ppalazon/hspecid-x/docs/includes/abbreviations.md

*[HSP]: HyperSpectral Pixel
*[HSI]: HyperSpectral Image
*[X-HEEP]: eXtendable Heterogeneous Energy-Efficient Platform
*[OBI]: Open Bus Interface
*[UAV]: Unmanned Aereal Vehicle
*[ECOSTRESS]: ECOsystem Spaceborne Thermal Radiometer Experiment on Space Station
*[VIS]: Visible
*[SWIR]: Shortwave Infrared
*[TIR]: Thermal Infrared
*[CNN]: Convolutional Neural Networks
*[GPU]: Graphics Processing Unit
*[FPGA]: Field-programmable gate array
*[ASIC]: Application-specific integrated circuit
*[DSA]: Domain-Specific Architecture
*[RTL]: Register Transfer Level
*[SoC]: System-on-a-Chip
*[MSE]: Mean Squared Error
*[MAD]: Mean Average Deviation
*[SAM]: Spectral Angle Mapper
*[SVA]: SystemVerilog Assertions
*[ISA]: Instruction Set Architecture
*[RISC]: Reduced Instruction Set Computer
*[ARM]: Advanced RISC Machines
*[CORE-V-XIF]: eXtension InterFace
*[XAIF]: eXtendible Accelerator InterFace
*[CGRA]: Coarse-Grained Reconfigurable Array
*[IMC]: In-Memory Computing
*[HLS]: High-Level Synthesis
*[FIFO]: First In, First Out
*[HSID]: HyperSpectral Identificator
*[CPU]: Central Processing Unit
*[DMA]: Direct Memory Access
*[IP]: Intellectual Property
*[AXI]: Advanced eXtensible Interface
*[AHB]: Advanced High-performance Bus
*[APB]: Advanced Peripheral Bus
*[DSP]: Digital Signal Processing
*[FSM]: Finite State Machine
*[DUT]: Device Under Test
*[RTOS]: Real-Time Operating System
*[UVM]: Universal Verification Methodology
