ppalazon/hspecid-x/reports/index.html

# Verificación de HSpecID-X

- hsid_fifo
- hsid_sq_df_acc
- hsid_mse
- hsid_mse_comp
- hsid_main
- hsid_x_obi_mem
- hsid_x_registers
- hsid_x_top
