ppalazon/hspecid-x/(commit log)

2025-06-29 Add fusesoc core and conf
2025-07-04 Add fusesoc cores for all submodules
2025-07-05 Set fusesoc core files on root directory
2025-07-11 Testing random insert on sq_df_acc
2025-07-11 Testing random insert on hsid_mse
2025-07-12 Fix vivado project generation tcl
    [hsid_main_tb.sv]
2025-08-11 Avoid using fork on xsim
    [hsid_x_top_tb.sv]
2025-08-15 Keep done, cancelled, error status in the status register until next change
    [hsid_x_registers.sv, hsid_x_registers_tb.sv, hsid_x_top_tb.sv]
2025-09-03 Change always_ff to always to let async reset works
    [hsid_fifo.sv, hsid_main_fsm.sv, hsid_mse.sv, hsid_mse_comp.sv, hsid_sq_df_acc.sv, hsid_x_obi_mem.sv, hsid_x_top_fsm.sv, hsp_obi_mem.sv]
2025-09-03 Fix wavedrom driagrams for mse and sq_df_acc
    [hsid_mse.sv, hsid_sq_df_acc.sv]
2025-09-25 Add K parameter to FuseSoC hsid_divider
2025-10-08 Include a reset synchronizer to async assert rst, sync de-assert rst
    [hsid_rst_sync.sv, hsid_rst_sync_tb.sv]
