ppalazon/hspecid-x/(notices)

Notices in the files:
README.md:
License: CERN-OHL-P v2
